FGalvagno/hsrl-control-pi/informe/portada.tex

% =============================================================
% Portada
% Regular espacios para que entre en una hoja, sin numerar (cuenta como i)
% =============================================================
\thispagestyle{empty}
\begin{center}
\begin{figure}[H]
    \centering
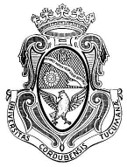
[picture p3: informe/figuras/0_unc.jpg]
    
\end{figure}

{\large UNIVERSIDAD NACIONAL DE C\'ORDOBA}\\[0.3cm]
{\large FACULTAD DE CIENCIAS EXACTAS, F\'ISICAS Y NATURALES}\\[0.3cm]
{\large CARRERA INGENIER\'IA ELECTR\'ONICA}

\vspace{1.5cm}

PROYECTO INTEGRADOR PARA LA OBTENCI\'ON DEL T\'ITULO DE GRADO\\
DE INGENIERO ELECTR\'ONICO

\vspace{2cm}

{\bfseries\Large ``SISTEMA AUTOMATIZADO DE CONTROL DE LONGITUD DE ONDA\\
PARA LIDAR DE ALTA RESOLUCI\'ON ESPECTRAL''}

\vspace{2cm}

\begin{tabular}{c}
Alumno \\[0.2cm]
Galvagno, Facundo Nahuel \\
\end{tabular}

\vspace{0.2cm}

\begin{tabular}{c}
Director \\[0.2cm]
Ing. Puig, Lucas M. D. \\
\end{tabular}

\vspace{0.2cm}

\begin{tabular}{c}
Co-Director \\[0.2cm]
Ing. Papandrea, Sebasti\'an Daniel \\
\end{tabular}

\vspace{0.2cm}

\begin{tabular}{c}
Co-Director \\[0.2cm]
Dr. Jin, Yoshitaka \\
\end{tabular}

\vspace{1.5cm}

C\'ordoba, Rep\'ublica Argentina\\
Agosto / 2026

\end{center}

\cleardoublepage
% Contratapa / reverso de tapa (version impresa tipo libro): pagina en blanco
\thispagestyle{empty}
\mbox{}
