FGalvagno/hsrl-control-pi/informe/preliminares/aprobacion_tribunal.tex

% =============================================================
% Hoja de Aprobacion del Tribunal Evaluador
% =============================================================
\thispagestyle{plain}

\begin{figure}[H]
    \centering
    
\end{figure}

\begin{center}
UNIVERSIDAD NACIONAL DE C\'ORDOBA\\
Facultad de Ciencias Exactas, F\'isicas y Naturales\\
Escuela de Ingenier\'ia Electr\'onica
\end{center}

\vspace{1.5cm}

El Tribunal Evaluador reunido en este acto y luego de haber aprobado la
Solicitud de Aprobaci\'on de Tema y efectuado las distintas instancias de
correcciones del Informe del Proyecto Integrador para la obtenci\'on del
T\'itulo de Grado ``Ingeniero Electr\'onico'' y cumpliendo con el Reglamento
correspondiente, declaran el Informe Final del estudiante Galvagno,
Facundo Nahuel como ``aceptado sin correcciones'' y la defensa oral Aprobada. Por lo tanto,
luego de haber tenido en cuenta los aspectos de evaluaci\'on que indica el
Reglamento, el Proyecto Integrador se considera Aprobado.

\vspace{1cm}

Se firma el Acta de Examen correspondiente y se distribuyen los ejemplares
impresos.

\vspace{2.5cm}

\noindent NOTA:

\vspace{2.5cm}

\noindent\hrulefill\\
Firma y aclaraci\'on del Tribunal Evaluador

\vspace{0.5cm}

\noindent Fecha:

\cleardoublepage
