FGalvagno/hsrl-control-pi/informe/preliminares/aval_director.tex

% =============================================================
% Aval del Director
% =============================================================
\thispagestyle{plain}

\begin{figure}[H]
    \centering
    
\end{figure}

\begin{center}
UNIVERSIDAD NACIONAL DE C\'ORDOBA\\
Facultad de Ciencias Exactas, F\'isicas y Naturales\\
Escuela de Ingenier\'ia Electr\'onica
\end{center}

\vspace{1.5cm}

Quien suscribe el Profesor Ing. Puig, Lucas M. D. en su carácter de Director del Proyecto Integrador del Estudiante Galvagno, Facundo Nahuel, denominado: SISTEMA AUTOMATIZADO DE CONTROL DE LONGITUD DE ONDA PARA
LIDAR DE ALTA RESOLUCIÓN ESPECTRAL, considera que el desarrollo del trabajo se ha completado según lo especificado en la Solicitud de Aprobación de Tema y se encuentra en condiciones de tramitar su defensa.

\vspace{1cm}

\noindent A los efectos de quien corresponda, en fecha \ldots /\ldots /\ldots

\vspace{3cm}

\hfill\begin{tabular}{c}
\hrulefill\\
Firma y aclaración del Director
\end{tabular}

\cleardoublepage
