FGalvagno/hsrl-control-pi/informe/anexos/anexo6_ilrc32.tex

% =============================================================
% Anexo IV - Abstract presentado en el ILRC32
% Avances presentados en la 32.a International Laser Radar Conference
% (5-10 de julio de 2026) \cite{galvagno2026ilrc}.
% =============================================================
\chapter{Abstract presentado en el ILRC32}
\label{anexo:ilrc32}

En el presente anexo se incluye el abstract/p\'oster ``Advances on
Automation of Wavelength Tuning for High Spectral Resolution Lidar''
\cite{galvagno2026ilrc}, presentado por el autor junto a los directores
y colaboradores del proyecto en la 32.\textsuperscript{a} International
Laser Radar Conference (ILRC32), donde se resumieron los avances
alcanzados hasta ese momento en el circuito de detecci\'on de picos y en
el modelo del fotodiodo (ver Cap\'itulos~\ref{cap:fotodeteccion} y
\ref{cap:diseno_deteccion_picos}).

\includepdf[pages=1,scale=0.85,offset=0 -28pt,pagecommand={\pagestyle{fancy}}]{anexos/pdf/ILRC32_abstract.pdf}
\includepdf[pages=2-,scale=0.85,offset=0 10pt,pagecommand={\pagestyle{fancy}}]{anexos/pdf/ILRC32_abstract.pdf}
\includepdf[pages=-,scale=0.85,offset=0 10pt,pagecommand={\pagestyle{fancy}}]{anexos/pdf/ILRC32Poster.pdf}
