FGalvagno/hsrl-control-pi/informe/anexos/anexo2_esquematico.tex

\chapter{Esquemático de la placa de control}
\label{anexo:esquematico}

Se reproducen a continuación las láminas del esquemático de la placa de
control descripta en el Capítulo \ref{cap:placacontrol}, exportadas desde
el proyecto de KiCad. La primera corresponde a la hoja raíz y las
restantes a las hojas jerárquicas del circuito de detección y del
circuito digital. Las láminas se imprimen en orientación apaisada para
conservar la legibilidad de las referencias y de los valores de los
componentes.

\begin{hojaapaisada}
\includepdf[pages=-,scale=0.92,pagecommand={\pagestyle{fancy}}]%
  {anexos/pdf/esquematico.pdf}
\end{hojaapaisada}
