FGalvagno/hsrl-control-pi/informe/anexos/anexo3_pcb.tex

\chapter{Circuito impreso (PCB) de la placa de control}
\label{anexo:pcb}

Se reproducen a continuación las láminas del circuito impreso descripto
en el Capítulo~\ref{cap:placacontrol}, exportadas desde el proyecto de
KiCad. Las primeras muestran por separado las capas de cobre y la
serigrafía; la última superpone todas las capas junto con el contorno de
placa y los componentes, tal como se envió a fabricación. Las láminas se
imprimen en orientación apaisada para conservar la escala del dibujo.

\begin{hojaapaisada}
\includepdf[pages=-,scale=0.92,pagecommand={\pagestyle{fancy}}]%
  {anexos/pdf/placa.pdf}
\includepdf[pages=-,scale=0.92,pagecommand={\pagestyle{fancy}}]%
  {anexos/pdf/placacompleta.pdf}
\end{hojaapaisada}
