FGalvagno/hsrl-control-pi/informe/main.tex

% !TEX root = main.tex
% =============================================================
% Informe Final - Proyecto Integrador
% Sistema Automatizado de Control de Longitud de Onda
% para LiDAR de Alta Resolucion Espectral (HSRL)
%
% Universidad Nacional de Cordoba
% Facultad de Ciencias Exactas, Fisicas y Naturales
% Carrera Ingenieria Electronica
%
% =============================================================

\documentclass[a4paper,11pt,twoside]{book}

% ---------- Idioma y codificacion ----------
\usepackage[utf8]{inputenc}
\usepackage[T1]{fontenc}
\usepackage[spanish,es-tabla]{babel}
\usepackage{textcomp} % simbolos como \textcelsius

% Nombres de secciones segun el manual de estilo (difieren de los
% predeterminados por babel-spanish: "Indice general", "Indice de
% tablas/figuras").
\addto\captionsspanish{%
  \renewcommand{\contentsname}{\'Indice}
  \renewcommand{\listtablename}{Lista de Tablas}
  \renewcommand{\listfigurename}{Lista de Figuras}
}
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
  \setlength{\paperwidth}{210mm}\setlength{\paperheight}{297mm}%
  \setlength{\pdfpagewidth}{210mm}\setlength{\pdfpageheight}{297mm}%
  \setlength{\headwidth}{\textwidth}%
}

%----------- Estilo de Tikz -----------
\input{diagramas/estilos-diagramas}

% ---------- Interlineado ----------
\usepackage{setspace}
\onehalfspacing % 1,5 espacios en el cuerpo del texto

% ---------- Figuras, tablas, graficos ----------
\usepackage{graphicx}
\usepackage{caption}
\usepackage{subcaption}
\usepackage{float}
\usepackage{booktabs}
\usepackage{longtable}
\usepackage{rotating} % hojas apaisadas para diagramas grandes
\usepackage{tabularx}
\usepackage{array}
% Figuras y tablas se separan del texto con 3 espacios (manual de
% estilo); formato de leyenda "Figura N: Descripcion (Fuente: ...)".
% Figuras y tablas: leyenda "Figura N: Descripcion (Fuente: ...)" sin negrita,
% centrada y algo mas angosta que el texto, pegada a la imagen. La separacion
% de 3 espacios del manual va entre el flotante y el cuerpo del texto.
\captionsetup{
  labelsep=colon,
  font=singlespacing,
  justification=centering,
  width=0.9\textwidth,
  skip=6pt
}
\setlength{\intextsep}{1.5\baselineskip}
\setlength{\textfloatsep}{1.5\baselineskip}

% ---------- Matematica ----------
\usepackage{amsmath}
\usepackage{amssymb}

% ---------- Codigo fuente (firmware / software) ----------
\usepackage{listings}
\usepackage{xcolor}

% ---------- Titulos de capitulo, seccion y subseccion ----------
% Capitulo: negrita 14 - Seccion: negrita 12 (numero seguido de punto,
% ej. "1.1.") - Subseccion: normal 12 (ej. "1.1.1"). Despues del titulo
% de Capitulo o Seccion: 3 espacios (aprox. 3 interlineados).
\usepackage{titlesec}
\titleformat{\chapter}[block]
  {\normalfont\bfseries\fontsize{14}{17}\selectfont}
  {Cap\'itulo \thechapter}{1em}{}
\titlespacing*{\chapter}{0pt}{0pt}{1.5\baselineskip}

\titleformat{\section}
  {\normalfont\bfseries\fontsize{12}{14}\selectfont}{\thesection.}{1em}{}
\titlespacing*{\section}{0pt}{1.3\baselineskip}{0.7\baselineskip}

\titleformat{\subsection}
  {\normalfont\fontsize{12}{14}\selectfont}{\thesubsection}{1em}{}
\titlespacing*{\subsection}{0pt}{1\baselineskip}{0.5\baselineskip}

% Rotulo de las entradas de anexo en el indice: en lugar del numero solo
% ("I", "II", ...) se compone "Anexo I: Titulo". Se activa mas abajo, al
% entrar en \appendix, sustituyendo \numberline dentro del propio .toc.
\newcommand{\anexonumberline}[1]{Anexo~#1:\hspace{0.5em}}

% ---------- Bibliografia y referencias ----------
% Numeracion continua entre Bibliografia (solo libros con ISBN) y Referencias
% (todo lo demas: links, hojas de datos, apuntes, IA, etc.)
\usepackage[
  backend=biber,
  style=numeric,
  sorting=none,
  defernumbers=true
]{biblatex}
\addbibresource{bibliografia.bib}
% Bibliografia/Referencias: espacio simple dentro de cada entrada y
% separacion de 1,5 interlineados entre entradas (manual de estilo).
\AtBeginBibliography{\singlespacing}
\setlength{\bibitemsep}{1.5\baselineskip}
\setlength{\bibhang}{0pt}

% Notas al pie y citas textuales en espacio simple (manual de estilo),
% independientemente del interlineado 1,5 del cuerpo del texto. El
% paquete setspace tipografia las notas al pie a espacio simple en
% forma automatica; solo se fuerza el espaciado en citas textuales.
\usepackage{etoolbox}
\AtBeginEnvironment{quote}{\singlespacing}
\AtBeginEnvironment{quotation}{\singlespacing}

% ---------- Encabezados y pies de pagina ----------
\usepackage{fancyhdr}
\setlength{\headheight}{14pt}
\pagestyle{fancy}
\fancyhf{}
\fancyhead[LE,RO]{\thepage}
\fancyhead[RE]{\nouppercase{\leftmark}}
\fancyhead[LO]{\nouppercase{\rightmark}}
\renewcommand{\headrulewidth}{1pt}
\fancypagestyle{plain}{
  \fancyhf{} % Limpia el pie de página
  \renewcommand{\headrulewidth}{0pt} % Quita la regla superior en estas páginas
}
% ---------- Hipervinculos ----------
\usepackage[hidelinks]{hyperref}
\usepackage{cleveref}

% =============================================================
\begin{document}

% -------------------------------------------------------------
% PORTADA (no se numera; la numeracion romana visible comienza
% en la pagina siguiente, con la Hoja de Aprobacion del Tribunal)
% -------------------------------------------------------------
\input{portada}

% -------------------------------------------------------------
% PRELIMINARES (numeracion romana)
% -------------------------------------------------------------
\pagenumbering{roman}
% El manual de estilo pide numeros romanos en minuscula lisa (i, ii,
% iii...)
\makeatletter
\renewcommand{\es@scroman}[1]{#1}
\makeatother
\renewcommand{\thepage}{\roman{page}}
\input{preliminares/aprobacion_tribunal}
\input{preliminares/aval_director}
\input{preliminares/dedicatoria}
\input{preliminares/agradecimientos}
\input{preliminares/resumen}
\input{preliminares/abstract}
\input{preliminares/resumo}

\cleardoublepage
\tableofcontents

\listoftables
\addcontentsline{toc}{chapter}{\listtablename}

\listoffigures
\addcontentsline{toc}{chapter}{\listfigurename}

\input{preliminares/lista_simbolos_v2}

% -------------------------------------------------------------
% CUERPO DEL INFORME (numeracion arabiga desde Capitulo 1)
% -------------------------------------------------------------
\mainmatter

\input{capitulos/cap01_introduccion}

\part{Marco Teórico}
\input{capitulos/cap02_lidar_hsrl}
\input{capitulos/cap03_fotodeteccion}

\part{Marco Metodológico}
\input{capitulos/cap04_deteccion_picos}
\input{capitulos/cap05_microcontrolador}
\input{capitulos/cap06_placa_control}
\input{capitulos/cap07_firmware}
\input{capitulos/cap08_software_hmi}
\input{capitulos/cap09_modeloexp}

\part{Resultados y Conclusiones}
\input{resultados}
\input{conclusiones}

% -------------------------------------------------------------
% BIBLIOGRAFIA Y REFERENCIAS (numeracion continua)
% -------------------------------------------------------------
% El titulo se compone con \chapter*, igual que Resultados y Conclusiones, para
% que herede el formato definido con titlesec. Por eso ambos \printbibliography
% van con heading=none: la opcion title no tiene efecto en ese caso.
\cleardoublepage
\chapter*{Bibliografía}
\phantomsection
\addcontentsline{toc}{chapter}{Bibliografía}
\printbibliography[type=book,heading=none]

\cleardoublepage
\chapter*{Referencias}
\phantomsection
\addcontentsline{toc}{chapter}{Referencias}
\printbibliography[nottype=book,heading=none]

% -------------------------------------------------------------
% ANEXOS
% -------------------------------------------------------------
\appendix

% Los anexos se numeran en romanos y se rotulan "Anexo" (no "Capitulo"),
% segun el manual de estilo. \appendix asigna letras por defecto.
\renewcommand{\thechapter}{\Roman{chapter}}
\titleformat{\chapter}[block]
  {\normalfont\bfseries\fontsize{14}{17}\selectfont}
  {Anexo \thechapter}{1em}{}

% En el indice, la entrada de capitulo se compone con \numberline{\thechapter},
% que para los anexos produce solo "I", "II", etc. Se redefine \numberline
% dentro del propio archivo .toc a partir de este punto, de modo que las
% entradas restantes queden rotuladas como "Anexo I: Titulo".
\renewcommand{\appendixname}{Anexo}
\addtocontents{toc}{\protect\let\protect\numberline\protect\anexonumberline}

% Orden segun aparicion en el cuerpo del informe.
\input{anexos/anexo1_codigo_nies}
\input{anexos/anexo2_esquematico}
\input{anexos/anexo3_pcb}
\input{anexos/anexo4_hojas_datos}
\input{anexos/anexo5_codigo}
\input{anexos/anexo6_ilrc32}

% -------------------------------------------------------------
% ANEXO DE LA CATEDRA PI 
% -------------------------------------------------------------
\backmatter
\cleardoublepage
\phantomsection
\addcontentsline{toc}{chapter}{Anexo del Proyecto Integrador}
\chapter*{Anexo del Proyecto Integrador}
  En el presente anexo se incluyen la Solicitud de Aprobación de Tema y los informes mensuales de avance del proyecto, presentados a la Cátedra de Proyecto Integrador durante el desarrollo del mismo.
\input{anexos/sat}
\input{anexos/informes_mensuales}

\end{document}
