FGalvagno/hsrl-control-pi/informe/capitulos/cap07_firmware.tex

% =====================================================================
%  Capítulo: Firmware de control embebido sobre Raspberry Pi Pico 2
%  Fragmento para insertar con \input{} en el documento principal.
%  Paquetes requeridos en el preambulo de la tesis: graphicx, booktabs,
%  listings, xcolor, amsmath, float, caption.
%  Ademas, en el preambulo:  \input{diagramas/estilos-diagramas}
%  (carga tikz y los estilos que usan las figuras de este capitulo).
%  Las figuras se incluyen con \input{diagramas/<nombre>}.
% =====================================================================

\chapter{Firmware de control embebido}
\label{cap:firmware}

Tal como se explicó en el Capítulo \ref{cap:introduccion}, el sistema de control de longitud de onda del \emph{seeder} del lidar HSRL fue originalmente implementado como un programa de PC, \texttt{wvcnt\_lec.cpp}, que adquiría las señales del detector a través de un osciloscopio Tektronix vinculado por USB-VISA y comandaba el \emph{seeder} por un puerto serie.

El \emph{firmware} documentado en este capítulo traslada la totalidad del lazo a un microcontrolador Raspberry Pi Pico 2 (RP2350). 

\section{Alcance de la funcionalidad del Firmware}
\label{sec:fw-alcance}

El microcontrolador digitaliza las señales $P_+$ y $P_-$ directamente con su conversor analógico-digital interno, sincronizado por hardware con la señal de sincronismo del láser \emph{host}, y escribe el \textit{setpoint} de temperatura del \emph{heater} del \emph{seeder} Continuum por una terminal serie asincrónica. La consola de operación se expone sobre USB en modo CDC, de forma que la interfaz gráfica descripta en el capítulo~\ref{cap:software_hmi} sea para monitoreo y cambio de modos, no así parte del lazo de control. Por lo tanto si la interfaz se cierra, el \emph{firmware} continúa controlando el proceso en el último estado en el que se encontraba.

\section{Principio de funcionamiento del control}
\label{sec:fw-principio}

El detector entrega dos señales, $P_+$ y $P_-$, tomadas a ambos lados de la línea de absorción. La variable controlada no es ninguna de ellas por separado sino su cociente

\begin{equation}
  \mathit{prt} \;=\; \frac{P_+}{P_-},
  \label{eq:prt}
\end{equation}

\noindent que resulta monótono creciente con la longitud de onda en el entorno del punto de trabajo. El uso del cociente en lugar de una amplitud absoluta cancela, en primer orden, las variaciones comunes a ambos canales: fluctuaciones de la energía por pulso del láser, deriva de ganancia del detector y cambios de transmisión del camino óptico. El lazo corrige entonces el \emph{setpoint} de temperatura para mantener este cociente dentro de una banda determinada, utilizando un control por histéresis con banda muerta.

El barrido inicial aprovecha que cada canal absorbe a una longitud de onda distinta: al barrer la temperatura, $P_+$ y $P_-$ atraviesan sus respectivos mínimos a temperaturas diferentes, y el punto de operación buscado es la temperatura media entre ambos. 

\section{Arquitectura del sistema}
\label{sec:fw-arquitectura}

La Figura~\ref{fig:fw-arquitectura} muestra la disposición del hardware y los enlaces de señal. El generador de ondas que dispara el láser entrega también el trigger que sincroniza la digitalización. Las salidas del detector se acondicionan al rango de entrada del conversor del RP2350 mediante un divisor resistivo y se conectan a dos canales analógicos. La comunicación con el \emph{seeder} es RS-232 y requiere un conversor de niveles respecto de la lógica TTL del microcontrolador. La terminal de operación y monitoreo funciona sobre USB en modo CDC.

\begin{figure}[htpb]
\centering
\resizebox{\textwidth}{!}{\input{diagramas/fw-arquitectura}}
\caption[Arquitectura de hardware del sistema de control]%
{Arquitectura de hardware (Fuente: elaboración propia).}
\label{fig:fw-arquitectura}
\end{figure}

El conexionado concreto se resume en la tabla~\ref{tab:fw-pines}. Todas las asignaciones de pines están centralizadas en \texttt{config.h}, de modo que una modificación del cableado no obliga a recorrer el resto del código.

\begin{table}[htbp]
\centering
  \begin{tabular}{@{}llp{0.20\textwidth}p{0.34\textwidth}@{}}
  \toprule
  \textbf{Señal} & \textbf{GPIO} & \textbf{Periférico} & \textbf{Observaciones} \\
  \midrule
  Trigger       & 13 & GPIO entrada & \textit{pull-down} interno habilitado \\
  $P_+$       & 26 & ADC canal 0  & rango $0$--$3{,}3$\,V \\
  $P_-$       & 27 & ADC canal 1  & rango $0$--$3{,}3$\,V \\
  Seeder TX     & 0  & UART0 TX     & $57\,600$ baud, 8N1 \\
  Seeder RX     & 1  & UART0 RX     & sin control de flujo \\
  LED de estado & --- & GPIO (\texttt{PICO\_DEFAULT\_} \texttt{LED\_PIN}) & señalización durante el arranque \\
  \bottomrule
  \end{tabular}
  \caption{Asignación de pines del RP2350 para la aplicación en HSRL (Fuente: elaboración propia).}
 \label{tab:fw-pines}
\end{table}

\subsection{Descomposición en módulos}

El \emph{firmware} se organiza en cuatro archivos más un encabezado de configuración, según se ilustra en la figura~\ref{fig:fw-modulos}. El criterio de partición es funcional puesto que cada módulo encapsula una función determinada. El módulo \texttt{control} en particular no conoce ni el conversor ni el puerto serie: recibe dos valores en punto flotante y devuelve incrementos, lo que lo hace verificable de forma aislada.

\begin{figure}[htbp]
\centering
\resizebox{0.92\textwidth}{!}{\input{diagramas/fw-modulos}}
\caption{Descomposición en módulos del firmware y sus dependencias (Fuente: elaboración propia).}
\label{fig:fw-modulos}
\end{figure}

\begin{table}[h]
\centering
  \begin{tabular}{@{}p{0.28\textwidth}p{0.64\textwidth}@{}}
  \toprule
  \textbf{Archivo} & \textbf{Responsabilidad} \\
  \midrule
  \texttt{hsrl-control.c} & \texttt{main()}, lazo de medición sobre \texttt{core0}, intérprete de comandos sobre \texttt{core1} y emisión de la línea \texttt{[log]} de guardado de datos. \\
  \texttt{adc\_capture.c/.h} & Captura del valor de pico de cada canal, sincronizada al trigger, y promediado de $n$ cantidad de capturas. \\
  \texttt{control.c/.h} & Máquina de estados de los modos de operación y cálculo de los incrementos del punto de consigna o set point. \\
  \texttt{seeder\_comm.c/.h} & Protocolo de comandos de texto tipo SCPI sobre UART. \\
  \texttt{config.h} & Pines, parámetros por defecto y límites de seguridad. Único punto de configuración operativa del sistema. \\
  \bottomrule
  \end{tabular}
  \caption{Responsabilidad de cada módulo (Fuente: elaboración propia).}
\label{tab:fw-modulos}
\end{table}

\section{Conversión de las señales del detector}
\label{sec:fw-adquisicion}

\subsection{Sincronismo y detección de pico}

La señal que entrega el detector es un pulso cuya amplitud de pico es la magnitud de interés. Como se describió anteriormente en el Capítulo \ref{cap:micro}, la estrategia de captura consiste en muestrear a la máxima velocidad posible durante la ventana en que el trigger permanece en nivel alto y conservar el máximo de las muestras obtenidas. El código~\ref{lst:fw-adc} reproduce el núcleo de la rutina.

\begin{lstlisting}[language=C,caption={Captura de pico sincronizada al trigger
  (\texttt{adc\_capture.c}).},label={lst:fw-adc},basicstyle=\ttfamily\footnotesize,
  columns=fullflexible,breaklines=true,frame=single,rulecolor=\color{black!30}]
uint16_t adc_capturar_pico(uint canal) {
    uint16_t maximo = 0;
    adc_select_input(canal);

    while (!gpio_get(PIN_TRIGGER)) {   // esperar el flanco de subida
        tight_loop_contents();
    }
    sleep_us(2);                       // retardo de establecimiento

    adc_fifo_setup(true, false, 1, false, false);
    adc_run(true);                     // free-running con FIFO

    while (gpio_get(PIN_TRIGGER)) {    // mientras dure el pulso
        if (!adc_fifo_is_empty()) {
            uint16_t val = adc_fifo_get();
            if (val > maximo) maximo = val;
        }
    }
    adc_run(false);

    while (!adc_fifo_is_empty()) {     // vaciar lo que quedo en el FIFO
        uint16_t val = adc_fifo_get();
        if (val > maximo) maximo = val;
    }
    adc_fifo_drain();
    return maximo;
}
\end{lstlisting}

En primer lugar, el conversor se configura sin divisor de reloj (\texttt{adc\_set\_clkdiv(0)}), lo que produce una tasa de conversión cercana a $500$\,kmuestras/s; con anchos de pulso del orden de la decena de microsegundos esto asegura varias muestras dentro de la ventana. En segundo lugar, la habilitación del FIFO desacopla la conversión de la lectura, de modo que una demora del lazo de software no pierde la muestra en curso. En tercer lugar, el retardo de $2$\,\textmu s posterior al flanco descarta el transitorio de establecimiento del multiplexor de entrada y el tiempo de encendido de láser, que de otro modo se computaría como una muestra incorrecta.

La resolución del conversor es de 12 bits sobre una referencia de $3{,}3$\,V, lo que da un escalón de cuantificación de $3{,}3/4095 \approx 0{,}806$\,mV.

\subsection{Muestreo intercalado y promediado}

Los dos canales se muestrean de forma intercalada: un pulso de trigger para $P_+$ y el siguiente para $P_-$. Como el cociente de la ecuación~\ref{eq:prt} se construye con mediciones tomadas en disparos consecutivos, el intercalado minimiza el intervalo entre ambas y, con él, la contribución de la deriva de temperatura al error. 

El sistema permite fijar en caliente el número $n$ de picos a promediar por canal, entre 1 y \texttt{N\_PROM\_MAX} $=100$. Los acumuladores son de 32 bits, holgadamente suficientes para $100$ muestras de 12 bits.

\subsection{Espera de estabilización}

El calentador de cavidad del láser \emph{seeder} presenta una constante de tiempo térmica no despreciable frente al período del ciclo. El \emph{setpoint} se escribe al final de un ciclo, pero la temperatura efectiva de la cavidad tarda en alcanzarlo. Medir inmediatamente después de la escritura equivaldría a muestrear sobre un transitorio, con el resultado de que el lazo reaccionaría a su propia dinámica de actuación en lugar de a la del proceso.

Por ese motivo el ciclo comienza con una pausa configurable, \texttt{espera\_ms} (comando \texttt{E}), de valor por defecto $10$\,s y tope $600$\,s. Durante la pausa el segundo núcleo continúa atendiendo comandos, de modo que el propio parámetro puede modificarse sin esperar a que el ciclo concluya.

\section{Lazo de control}
\label{sec:fw-control}

\subsection{Modos de operación}

El controlador implementa cinco modos, que la figura~\ref{fig:fw-estados} presenta como una máquina de estados. Los modos \textsc{forward} y \textsc{backward} realizan un barrido en lazo abierto aplicando un incremento de paso grueso en cada ciclo, y son los que se utilizan durante la búsqueda de los mínimos. El modo \textsc{lock} es el único que cierra el lazo de control.

\begin{figure}[h]
\centering
\resizebox{\textwidth}{!}{\input{diagramas/fw-estados}}
\caption[Máquina de estados de los modos de operación]%
{Máquina de estados de los modos de operación. Las transiciones punteadas no provienen de un comando sino de la protección de rango de temperatura máxima (Fuente: elaboración propia).}
\label{fig:fw-estados}
\end{figure}

\subsection{Ley de control del sistema}

Al ingresar en el modo \textsc{lock} el controlador captura como referencia $\mathit{prt}_{\mathrm{ref}}$ el valor del cociente correspondiente a \textbf{dos ciclos atrás}. El criterio tiene una justificación, ya que el ciclo inmediatamente anterior pudo haberse medido mientras la temperatura todavía convergía hacia el último punto de consigna del barrido, mientras que el ciclo previo a ése corresponde a una condición ya estabilizada. Tomar la referencia del historial evita, además, introducir un ciclo adicional de espera al momento de la sintonización.

La ley de control es de tipo histéresis \emph{bang-bang} con banda muerta multiplicativa:

\begin{equation}
  \Delta_{\text{heater}} =
  \begin{cases}
    -\,\delta_{f} & \text{si } \mathit{prt} > \mathit{prt}_{\mathrm{ref}}\cdot\mathrm{coe},\\[4pt]
    +\,\delta_{f} & \text{si } \mathit{prt} < \mathit{prt}_{\mathrm{ref}}/\mathrm{coe},\\[4pt]
    0             & \text{en otro caso},
  \end{cases}
  \label{eq:lock}
\end{equation}

donde $\delta_{f}$ es el paso fino de temperatura y $\mathrm{coe}=1{,}23$ el coeficiente de banda muerta. La figura~\ref{fig:fw-banda} representa gráficamente la ecuación~\ref{eq:lock}.

\begin{figure}[htbp]
\centering
\resizebox{0.95\textwidth}{!}{\input{diagramas/fw-banda}}
\caption[Banda muerta multiplicativa del modo de sintonía]%
{Banda muerta multiplicativa del modo de sintonía. El ancho relativo de la banda es constante y no depende del valor absoluto de la referencia (Fuente: elaboración propia).}
\label{fig:fw-banda}
\end{figure}

La elección de una banda \emph{multiplicativa} es debido a que el cociente $\mathit{prt}$ carece de unidades y su valor absoluto puede variar entre sesiones según el punto de trabajo. La banda cumple la función habitual de la zona muerta en un control \textit{bang-bang}: impedir que el actuador corrija permanentemente sobre el ruido de medición, a costa de un error de régimen acotado y de un ciclo límite de amplitud igual, a lo sumo, a un paso fino.

\subsection{Protección de rango}

Antes de calcular el incremento o decremento de temperatura de cavidad, cada ciclo verifica que el \emph{setpoint} permanezca dentro del intervalo $[h_{\min}, h_{\max}]$ declarado en \texttt{config.h} (por defecto $62{,}5$--$63{,}1$\,\textdegree C). Si lo excede, el controlador fuerza el modo de barrido en dirección opuesta al actual. Si el sistema está sintonizado, anula la bandera \texttt{lock\_activo}, volviendo al modo de barrido.

\subsection{Estructura del ciclo}

La Figura \ref{fig:fw-ciclo} sintetiza el ciclo completo que ejecuta \texttt{core0}. Primero el sistema copia \texttt{n\_prom} y \texttt{espera\_ms} en sección crítica, debido a que estas variables son escritas por el \texttt{core1} pero accedidas por el \texttt{core0}. El uso de una sección crítica \cite{rpisdk} permite evitar los problemas típicos de concurrencia al acceder simultáneamente a una variable, como condición de carrera o \textit{race\ condition}. Luego el ciclo espera el tiempo de estabilización (de ser necesario), captura los pulsos del ADC ante una entrada de SYNC (señal de sincronismo del láser \emph{host}), los normaliza y escala para posteriormente aplicar la ley de control y enviar los \emph{setpoints} al \emph{seeder}.

Finalmente, el microcontrolador confirma los valores escritos en el \emph{seeder} y al terminar el ciclo envía todas las variables consultadas anteriormente en la terminal, con la etiqueta \texttt{log}.

\begin{figure}[htpb]
\centering
\resizebox{!}{0.85\textheight}{\input{diagramas/fw-ciclo}}
\caption{Ciclo de medición y control ejecutado por \texttt{core0} (Fuente: elaboración propia).}
\label{fig:fw-ciclo}
\end{figure}

\section{Comunicación con el seeder}
\label{sec:fw-seeder}

\subsection{Protocolo}

El \emph{seeder} Continuum expone un conjunto de comandos de texto de sintaxis similar a SCPI, terminados en \texttt{\textbackslash r\textbackslash n}, sobre una línea RS-232 configurada a $57\,600$ baudios, 8N1, sin control de flujo. La Tabla~\ref{tab:fw-scpi} enumera los comandos utilizados por el \emph{firmware}.

\begin{table}[htbp]
\centering
  \begin{tabular}{@{}p{0.34\textwidth}p{0.58\textwidth}@{}}
  \toprule
  \textbf{Comando} & \textbf{Función} \\
  \midrule
  \texttt{:syst:pass:cen "NP"}    & Habilitar los comandos protegidos. \\
  \texttt{:syst:pass:cdis "NP"}   & Volver a protegerlos. \\
  \texttt{:syst:pass:cen:stat?}   & Estado de la protección. \\
  \texttt{:syst:tcon2:spo} \textbar\ \texttt{?} & Escribir o leer el punto de consigna del calefactor. \\
  \texttt{:syst:tmon2:temp?}      & Leer la temperatura medida. \\
  \texttt{:syst:pdr:volt} \textbar\ \texttt{?}  & Escribir o leer la tensión del piezoeléctrico. \\
  \texttt{:syst:smod:flag?}       & Banderas de \emph{second mode}. \\
  \texttt{:syst:err?}             & Cola de errores (FIFO, hasta 10 entradas). \\
  \texttt{*CLS}                   & Limpiar la cola de errores. \\
  \bottomrule
  \end{tabular}
  \caption{Comandos del seeder empleados por el firmware (Fuente: adaptado de \cite{npphotonics_flm005}).}
\label{tab:fw-scpi}
\end{table}

\subsection{Habilitación de los comandos protegidos}

El \emph{seeder} inicia siempre con los comandos de configuración protegidos. Esto quiere decir que sin habilitación previa, las escrituras de temperatura y de tensión del piezoeléctrico se descartan. El \emph{firmware} envía la contraseña durante la inicialización del mismo, incluso antes de esperar a que se establezca la consola USB, y reintenta hasta \texttt{UNLOCK\_MAX\_INTENTOS} $=5$ veces con \texttt{UNLOCK\_REINTENTO\_MS} $=2000$\,ms de separación, porque el \emph{seeder} puede encontrarse todavía en su propia secuencia de arranque cuando el microcontrolador ya está operativo.

Durante esta etapa no hay consola disponible, de modo que los mensajes de diagnóstico se perderían. Como única señal de vida se utiliza el LED de la placa, encendido de forma continua mientras se cursa un intento y parpadeando durante la espera entre intentos, lo que permite distinguir a simple vista el estado actual de la placa. El resultado se almacena y se informa por consola una vez que se establece conexión con la interfaz serie del \emph{seeder}.

Un detalle de implementación merece mención por lo difícil que resultó de diagnosticar. La secuencia de habilitación del \emph{seeder} debe comenzar enviando \texttt{*CLS}, comando cuyo efecto útil es evitar que el \emph{seeder} detecte como byte de datos algún flanco ocurrido al configurar el UART. Sin este comando, la habilitación de los comandos protegidos no era posible.

\subsection{Verificación de escrituras y diagnóstico}

Dado que el protocolo no acusa recibo de las escrituras, el \emph{firmware} implementa una verificación explícita mediante el comando \texttt{w}: lee el \emph{setpoint} antes de escribirlo por terminal, lo escribe, y lo vuelve a leer. La comparación permite distinguir tres situaciones: aceptación, rechazo (el valor no se movió) y una condición anómala en la que el \emph{seeder} adoptó un valor distinto del solicitado. El comando \texttt{d} complementa lo anterior consultando el estado de la protección y vaciando la cola de errores del \emph{seeder}. Los códigos posibles son $-203$ (comando protegido), $-102$ (error de sintaxis), $-121$ (carácter inválido en un número) y $-222$ (dato fuera de rango). Su implementación se realizó con ayuda del manual de referencia \cite{npphotonics_flm005}, utilizando código de ejemplo del mismo.

\subsection{Detección de segundo modo}

Al cierre de cada ciclo el \emph{firmware} consulta \texttt{:syst:smod:flag?}. El bit 0 en 1 indica que el \emph{seeder} abandonó la operación en monomodo o \textit{single mode} hacia \emph{second mode}, condición bajo la cual la medición de ese ciclo no es representativa.

El \emph{firmware} informa la condición pero no actúa sobre ella: no descarta la medición ni suspende el lazo. Esta decisión es deliberada puesto que podría enmascarar un problema con el lidar. Por este motivo es posible cambiar la tensión del piezoeléctrico del \emph{seeder}. Al cambiar la tensión del piezoeléctrico podemos quitar al \emph{seeder} de la condición de \emph{second mode}.

\section{Concurrencia y aprovechamiento de los dos núcleos}
\label{sec:fw-concurrencia}

El ciclo de medición es intrínsecamente bloqueante: la espera del trigger, la pausa de estabilización y las transacciones con el \emph{seeder} inmovilizan el hilo de ejecución por intervalos que pueden alcanzar varios segundos. Atender la consola desde ese mismo hilo obligaría a realizar un \textit{polling} del puerto entre operaciones o utilizar interrupciones.

Puesto que el RP2350 dispone de dos núcleos, se dispone de una solución directa: \texttt{core0} ejecuta el lazo de medición y control, y \texttt{core1} atiende la consola en modo bloqueante. El diagrama de secuencias de la Figura \ref{fig:fw-secuencia} ilustra la interacción entre los dos núcleos y los recursos compartidos.

\begin{figure}[htbp]
\centering
\resizebox{\textwidth}{!}{\input{diagramas/fw-secuencia}}
\caption[Concurrencia entre núcleos y arbitraje de recursos compartidos]%
{Concurrencia entre núcleos y arbitraje de los dos recursos compartidos (Fuente: elaboración propia).}
\label{fig:fw-secuencia}
\end{figure}

Existen dos recursos compartidos, y cada uno recibe el mecanismo de exclusión que le corresponde:

\begin{itemize}
\item \textbf{Las estructuras de parámetros y estado} (\texttt{g\_params}, \texttt{g\_estado}) se protegen con una sección crítica (\texttt{critical\_section\_t}), que inhibe las interrupciones. Las regiones protegidas son deliberadamente breves (una asignación y una copia de la estructura) de modo que \texttt{core0} nunca queda esperando por una operación de salida.

\item \textbf{El puerto UART hacia el seeder} se protege con un \emph{mutex} (\texttt{mutex\_t}). Aquí la elección es distinta porque una transacción completa (envío del comando y lectura de la respuesta) puede demorar cientos de milisegundos, y mantener las interrupciones inhibidas durante ese intervalo degradaría el resto del sistema. El envío y la lectura deben ejecutarse bajo el mismo bloqueo puesto que si se separaran, el otro núcleo podría enviar un comando diferente y los núcleos leerían respuestas cruzadas en el puerto UART.
\end{itemize}

Adicionalmente, el valor de $n$ y el tiempo de espera se copian a variables locales al comienzo de cada ciclo, bajo la sección crítica. La copia rige para todo el ciclo, de modo que un cambio ordenado por el operador a mitad del promediado no altera el número de muestras que se están acumulando. Esto implica que el nuevo valor entra en vigor a partir del ciclo siguiente.

\section{Interfaz de operación}
\label{sec:fw-consola}

\subsection{Consola de comandos}

La consola distingue dos familias de comandos. Los de modo y consulta constan de un único carácter y se ejecutan de inmediato. Los comandos de parámetro constan de una letra seguida de un valor y se acumulan en un buffer hasta recibir el fin de línea. Los comandos posibles se encuentran detallados en la Tabla \ref{tab:fw-params}.

\begin{table}[htbp]
\centering
  \begin{tabular}{@{}cllr@{}}
  \toprule
  \textbf{Cmd} & \textbf{Parámetro} & \textbf{Ejemplo} & \textbf{Defecto} \\
  \midrule
  \texttt{P} & Tensión del piezoeléctrico        & \texttt{P2.500}    & $2{,}0$ \\
  \texttt{V} & Paso del piezoeléctrico           & \texttt{V0.010}    & $0{,}0$ \\
  \texttt{T} & Punto de consigna del calefactor  & \texttt{T62.140}   & $62{,}14$ \\
  \texttt{N} & Límite inferior del calefactor    & \texttt{N62.500}   & $62{,}5$ \\
  \texttt{X} & Límite superior del calefactor    & \texttt{X63.100}   & $63{,}1$ \\
  \texttt{R} & Paso grueso                       & \texttt{R0.069923} & $0{,}069923$ \\
  \texttt{M} & Paso medio                        & \texttt{M0.017750} & $0{,}01775$ \\
  \texttt{I} & Paso fino                         & \texttt{I0.004438} & $0{,}0044375$ \\
  \texttt{A} & Picos a promediar por canal       & \texttt{A5}        & $1$ (máx. $100$) \\
  \texttt{E} & Espera de estabilización, s       & \texttt{E10}       & $10$ (máx. $600$) \\
  \bottomrule
  \end{tabular}
  \caption{Comandos de parámetro y sus valores por defecto (Fuente: elaboración propia).}
\label{tab:fw-params}
\end{table}

Los comandos \texttt{A} y \texttt{E} son los únicos que aplican saturación sobre el valor recibido para limitar rangos; el resto se acepta tal cual, delegando la validación de rango en el \emph{seeder}, que responde con el código $-222$ ante un dato fuera de rango. Nótese que la tensión del piezoeléctrico se escribe pero su paso permanece en cero porque para esta versión del software la totalidad de la sintonización se realiza por temperatura.

\subsection{Registro de variables del sistema}
\label{sec:fw-log}

La salida por consola cumple dos propósitos difícilmente compatibles entre sí. Durante la puesta a punto a un operador o al mismo desarrollador le interesa una traza legible, con una línea por operación y suficiente contexto para entender qué está haciendo el sistema. Para una HMI, en cambio, esa misma traza obliga al programa corriendo en la PC a reconstruir el estado del equipo juntando fragmentos dispersos en varias líneas de la terminal con diversos contextos.

La solución adoptada consiste en mantener la traza legible y agregar, al cierre de cada ciclo de medición, una única línea autocontenida en formato CSV:

\begin{lstlisting}[basicstyle=\ttfamily\scriptsize,columns=fullflexible,
  breaklines=true,frame=single,rulecolor=\color{black!30}]
[log] 27,f,62.8500,62.8471,2.0000,2.0013,0.312345,0.253012,1.234567,
      +0.069923,0,,,,1,10,0,0
\end{lstlisting}

Los nombres de las columnas no se codifican dentro de la línea de datos sino que se transmiten por separado, al arrancar y como respuesta al comando \texttt{?}:

\begin{lstlisting}[basicstyle=\ttfamily\scriptsize,columns=fullflexible,
  breaklines=true,frame=single,rulecolor=\color{black!30}]
[logcols] ciclo,modo,heater_sp,heater_real,piezo_sp,piezo_real,pp,pm,prt,
          d_heater,lock_activo,lock_ref,lock_lo,lock_hi,n_prom,espera_s,
          smod,segundo_modo
\end{lstlisting}

Esto permite que el software que recibe la información por puerto serie pueda construir el encabezado de su archivo de salida a partir de lo que el \emph{firmware} declara, en lugar de mantener una copia de la lista. Si en el futuro se agregan columnas, el mismo software de PC las incorpora sin modificaciones. 

El csv generado además posee dos reglas de interpretación:

\begin{enumerate}
\item El separador es la coma y el separador decimal es el punto según formato de archivos \texttt{csv} tradicional.
\item Un campo vacío significa que el dato no existe en ese ciclo, y no que valga cero.
\end{enumerate}

Esta última distinción permite diferenciar una situación de no respuesta del \emph{seeder} (que sería causal de alarma para la interfaz), de un cero verdadero.

\section{Configuración y compilación}
\label{sec:fw-build}

Toda la parametrización del sistema reside en \texttt{config.h}: pines, velocidades de comunicación, parámetros de reintento, valores por defecto del control y límites de seguridad. La regla de diseño es que ninguna constante significativa aparezca dispersa en el código.

La compilación se realiza con CMake y Ninja sobre el SDK oficial de Raspberry Pi Pico en su versión 2.3.0, con la cadena de herramientas ARM 15\_2\_Rel1. La placa objetivo se declara como \texttt{PICO\_BOARD=pico2}. La salida estándar se dirige a USB y no a UART, ya que este último está dedicado por completo a la comunicación con el \emph{seeder}:

\begin{lstlisting}[basicstyle=\ttfamily\footnotesize,columns=fullflexible,
  frame=single,rulecolor=\color{black!30}]
pico_enable_stdio_uart(hsrl-control 0)
pico_enable_stdio_usb(hsrl-control 1)

target_link_libraries(hsrl-control
        pico_stdlib
        hardware_adc  hardware_gpio  hardware_uart
        hardware_sync pico_multicore)
\end{lstlisting}
