FGalvagno/hsrl-control-pi/informe/capitulos/cap08_software_hmi.tex

% =============================================================
% Capítulo 9 - Desarrollo del software de interfaz (HMI)
% =============================================================
\chapter{Desarrollo del software de interfaz (HMI)}
\label{cap:software_hmi}

El software de interfaz hombre-máquina (HMI, por sus siglas en inglés \emph{Human-Machine Interface}) constituye la capa de supervisión y control del sistema automatizado de sintonización en longitud de onda para el HSRL. Este desarrollo reemplaza el esquema previo basado en scripts en Visual C++ por una solución integrada, robusta y amigable para el operador.

El software HMI debe permitir la interacción entre el usuario y el microcontrolador de la placa de control, incluyendo la visualización del estado de sintonización del sistema, la lectura de parámetros del lazo de control y la modificación de funciones y \emph{setpoints} de operación.

\section{Requisitos funcionales y de diseño}
\label{sec:reqhmi}

Para garantizar la operabilidad, confiabilidad y seguridad del sistema, se establecieron los siguientes requisitos funcionales y de diseño específicos:

\begin{itemize}
    \item Visualización continua del estado operativo de sintonización (sintonizando, bloqueado en longitud de onda, fuera de rango o error), así como el despliegue gráfico de las señales adquiridas por los detectores de pico ($P_+$ y $P_-$) y el valor de salida del actuador de temperatura $T(k)$.
    \item Permitir al usuario modificar dinámicamente los parámetros del lazo de control, enviar \emph{setpoints}, seleccionar modos de operación (Manual / Automático) y enviar comandos de control a la placa de control.
    \item Notificación inmediata y clara ante desvíos de los parámetros de sintonización, pérdidas de señal pulsada, fallas de comunicación o sobrepasos de umbrales en los fotodetectores.
    \item Almacenamiento periódico de la telemetría del sistema y eventos en archivos de registro (\emph{log files}) para su posterior análisis y diagnóstico.
\end{itemize}

Si bien no es requisito utilizar una norma puntual, se considera como una buena práctica seguir estándares probados, por lo tanto el diseño toma como base los lineamientos de la norma ISA-101 introducidos en la Sección~\ref{sec:isa101} y el principio de alarmas de la ISA-18.2, introducido en la Sección~\ref{sec:alarmas}.

\section{Principios de la norma ISA-101}
\label{sec:isa101}

La norma ANSI/ISA-101.01-2015 (\emph{Human Machine Interfaces for Process Automation Systems}) establece directrices de diseño orientadas a maximizar la conciencia situacional (\emph{situation awareness}) del operador, reducir el tiempo de respuesta ante eventos anómalos y minimizar la fatiga visual. Para la implementación de la HMI del sistema HSRL se adoptaron los siguientes principios fundamentales de la norma \cite{isa101}:

\begin{enumerate}
    \item \textbf{Filosofía de color simplificada y funcional:} se emplean fondos neutros en tonos de gris claro para los paneles y ventanas principales, evitando contrastes elevados que generen cansancio visual durante jornadas prolongadas de medición. El uso de colores vivos se reserva exclusivamente para la representación de estados de alarma o advertencias (rojo para fallas críticas, amarillo/ámbar para advertencias y verde o gris neutro para estados normales de operación).
    \item \textbf{Jerarquía estructurada de pantallas:} se define una distribución organizada del contenido funcional dividida en áreas bien delimitadas:
    \begin{itemize}
        \item \emph{Barra de estado superior (Header):} muestra el estado global de conexión serie, modo de operación actual (Manual/Automático) y el indicador sintético de sintonización (\emph{LOCKED/UNLOCKED}).
        \item \emph{Panel de proceso y gráficos en tiempo real:} despliega tendencias temporales de las señales $P_+$, $P_-$ y parámetros del control por histéresis, permitiendo evaluar la estabilidad del lazo de control de un solo vistazo.
        \item \emph{Panel de comandos y ajustes:} agrupa los controles interactivos para ingresar \emph{setpoints}, modificar el punto de operación y modo.
    \end{itemize}
\end{enumerate}

\section{Alarmas del sistema}
\label{sec:alarmas}

La gestión de alarmas se diseñó siguiendo los principios de la norma ANSI/ISA-18.2 (\emph{Management of Alarm Systems for the Process Industries}). El objetivo es garantizar que cada alarma presentada al operador responda a una condición anómala real que requiera una acción o toma de decisión consciente, evitando el fenómeno de desensibilización por saturación de alarmas (\emph{alarm flooding}) \cite{isa182}.

Las alarmas de la HMI se categorizan en dos niveles de prioridad:

\begin{itemize}
    \item \textbf{Prioridad Alta:} condición que compromete el funcionamiento del sistema o la integridad de la medición (por ejemplo, pérdida total de pulsos en los fotodetectores, error de comunicación serie prolongado o desintonización crítica del lazo). Requiere atención inmediata del operador. Representación en rojo.
    \item \textbf{Prioridad Media:} desviaciones temporales de la temperatura por encima de los umbrales de tolerancia preestablecidos, o variaciones térmicas drásticas en el actuador $T(k)$. Representación en amarillo/ámbar.
\end{itemize}

\section{Modelo de HMI}

A partir de los criterios establecidos en la Sección \ref{sec:reqhmi} y las normas discutidas en las Secciones \ref{sec:isa101} y \ref{sec:alarmas} se creó el borrador de HMI presentado en la Figura \ref{fig:inks}, con los botones y comandos necesarios para la operación de sistema, utilizando el software Inkscape.

\begin{figure}
    \centering
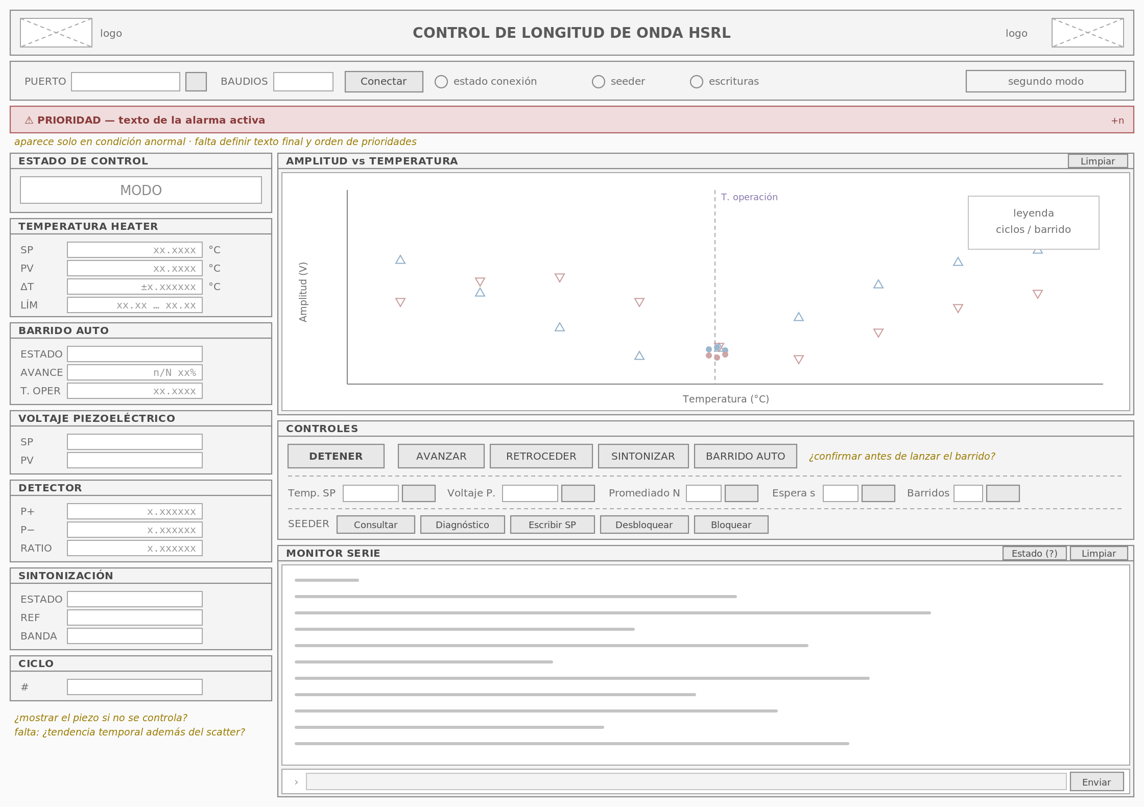
[picture p35: informe/figuras/8_borradorhmi.png]
    
    \caption{Borrador de la HMI creado en Inkscape (Fuente: elaboración propia).}
    \label{fig:inks}
\end{figure}

\section{Arquitectura del software en Python}
\label{sec:arquitectura_python}
\label{sec:hmi-arquitectura}

Se implementó la HMI en Python, con Tkinter para la interfaz gráfica. El código fuente se documenta y versiona en el repositorio del proyecto. La aplicación tiene exactamente dos dependencias externas fundamentales: \texttt{pyserial} para la comunicación por puerto USB con la placa de control y \texttt{matplotlib} para la representación gráfica; Tkinter forma parte de la biblioteca estándar. El software se organiza en siete módulos, según muestra la Figura~\ref{fig:hmi-modulos}.

\begin{figure}[htbp]
    \centering
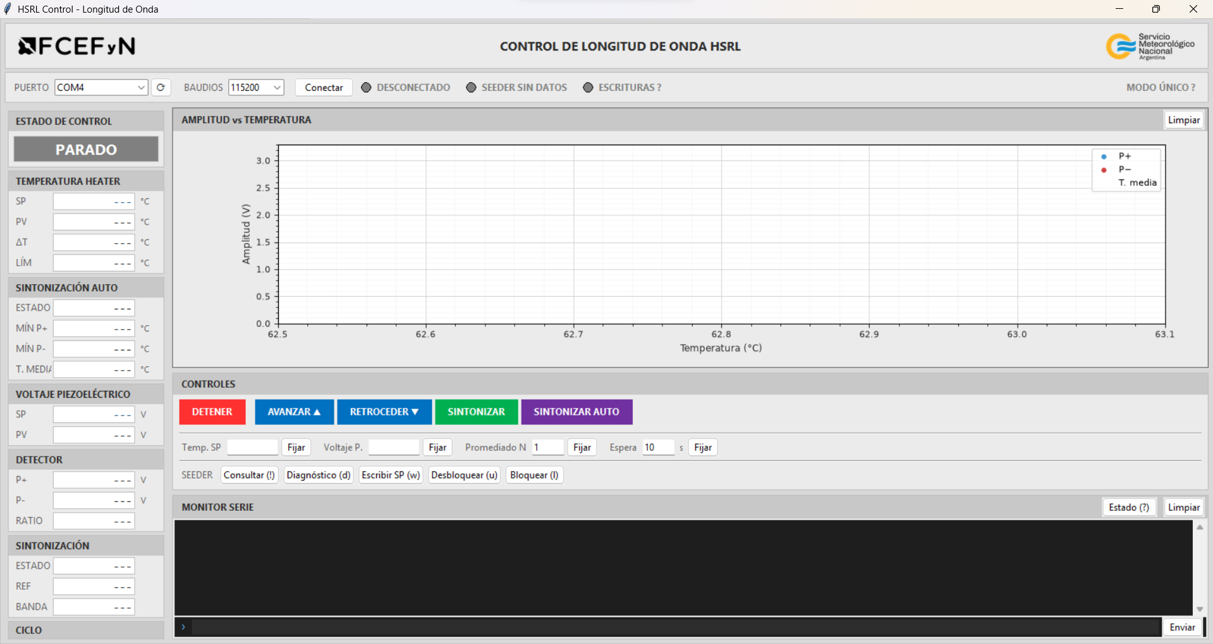
[picture p36: informe/figuras/8_hmilayout.png]
    
    \caption{HMI generada por \texttt{hmi.py}, a partir de la referencia proporcionada al modelo de inteligencia artificial Claude Opus 4.7 \cite{claudeopus47} (Fuente: elaboración propia).}
    \label{fig:hmiopus}
\end{figure}

La base de los módulos \texttt{hmi.py}, \texttt{serie.py} y \texttt{telemetria.py} fue creada a partir del uso del modelo de IA Claude Opus 4.7 \cite{claudeopus47}, con la consigna ``crear HMI a partir de la imagen de borrador proporcionado. Cada comando de la recepción mediante pySerial debe interactuar con el \emph{firmware} proporcionado con sus respectivos botones y campos de E/S y debes de loggear el estado del equipo a través de las líneas de diagnóstico del mismo''. Luego fueron modificados y adaptados según la necesidad del proyecto. Los archivos proporcionados de referencia para el modelo fueron el borrador de la Figura \ref{fig:inks} y los archivos \emph{hsrl-control.c} y \emph{config.h}, junto con el registro de la terminal durante 40 ciclos de adquisición.

\begin{figure}[htbp]
\centering
\resizebox{\textwidth}{!}{\input{diagramas/hmi-modulos}}
\caption{Arquitectura de módulos de la interfaz de operación (Fuente: elaboración propia).}
\label{fig:hmi-modulos}
\end{figure}

\begin{table}[htbp]
\centering
  \begin{tabular}{@{}p{0.24\textwidth}p{0.68\textwidth}@{}}
  \toprule
  \textbf{Módulo} & \textbf{Responsabilidad} \\
  \midrule
  \texttt{hmi.py} & Clase \texttt{HmiApplication}: construcción de la pantalla, ciclo de sondeo, envío de comandos y secuencia de sintonización automática. Punto de entrada. \\
  \texttt{serie.py} & Clase \texttt{SerialLink}: apertura, cierre, hilo de lectura y cola de líneas. Traduce toda falla del puerto a \texttt{SerialLinkError}. \\
  \texttt{telemetria.py} & Modelo del proceso (\texttt{ProcessData}) y análisis de las líneas de texto del \emph{firmware}. \\
  \texttt{registro.py} & \texttt{session\_log()} para el \textit{timestamp} y \texttt{CycleCsvWriter} para la escritura del archivo CSV. \\
  \texttt{widgets.py} & Componentes reutilizables (\texttt{StatusIndicator}, \texttt{StatusLabel}, \texttt{group\_box()}, \texttt{value\_row()}) con el estilo ya aplicado. \\
  \texttt{estilo.py} & Paleta y tipografía conforme a ISA-101. \\
  \texttt{firmware.py} & Constantes que deben coincidir con las del \emph{firmware}. \\
  \bottomrule
  \end{tabular}
  \caption{Responsabilidad de cada módulo de la interfaz (Fuente: elaboración propia).}
  \label{tab:hmi-modulos}
\end{table}

Para centralizar los datos del proceso se utiliza la clase \texttt{ProcessData}. Esta clase posee todos sus atributos declarados en el constructor, con la unidad y el significado al lado, lo que hace que el modelo del proceso se lea como una especificación de qué sabe la interfaz sobre el instrumento. La ventaja de esta aproximación es que permite probar separado el módulo \texttt{telemetria.py} del resto de la interfaz, para validar respuestas del microcontrolador sin necesidad de pasar por la interfaz HMI. Esta clase se discute más en detalle en la Sección~\ref{sec:hmi-telemetria}.

\section{Puerto serie y concurrencia}
\label{sec:hmi-concurrencia}

Tkinter impone que todo acceso a los componentes gráficos debe ocurrir desde el hilo que ejecuta el bucle de eventos (invocado por \texttt{hmi.py}). Al mismo tiempo, la lectura del puerto serie debe ser continua para no perder datos. La estructura adoptada, ilustrada en la Figura~\ref{fig:hmi-datos}, resuelve ambas restricciones.

\begin{figure}[htbp]
\centering
\resizebox{0.85\textwidth}{!}{\input{diagramas/hmi-datos}}
\caption[Diagrama de flujo de un ciclo de \textit{log}]%
{Recorrido de un ciclo de telemetría desde el puerto hasta la interfaz gráfica (Fuente: elaboración propia).}
\label{fig:hmi-datos}
\end{figure}

\begin{itemize}
\item Un \textbf{hilo secundario} creado en la clase SerialLink lee del puerto, acumula los bytes en un buffer, separa las líneas completas y las deposita en una \texttt{queue.Queue}.
\item El \textbf{hilo principal} ejecuta \texttt{\_poll\_serial()} cada $100$\,ms, con \texttt{root.after()}. Este hilo lee la cola de mensajes completos, la vacía y actualiza la interfaz gráfica.
\end{itemize}

Cuando no hay bytes disponibles, el hilo secundario duerme $5$\,ms y cuando directamente no hay puerto abierto, la pausa sube a $50$\,ms. Esta implementación es para evitar consumir recursos innecesariamente cuando no existan datos por leer. Las fallas de \texttt{pyserial} se traducen dentro de \texttt{serie.py} a una excepción propia, \texttt{SerialLinkError}.

\section{Lectura de datos del proceso}
\label{sec:hmi-telemetria}

Como se estableció en la Sección~\ref{sec:fw-log}, el \emph{firmware} envía al finalizar un ciclo de medición una línea \texttt{[log]}, y anuncia los nombres de sus columnas por separado en \texttt{[logcols]}. La interfaz se apoya íntegramente en estos dos mecanismos y por lo tanto el estado del proceso se reconstruye a partir de esa única línea.

Mediante los nombres anunciados en \texttt{[logcols]} con los valores de la línea \texttt{[log]}, el programa construye un diccionario de nombre a texto. Luego ese diccionario se lee para obtener los campos que la interfaz necesita:

\begin{lstlisting}[language=Python,basicstyle=\ttfamily\footnotesize,
  columns=fullflexible,breaklines=true,frame=single,rulecolor=\color{black!30}]
fields = {}
values = data.log_row_raw.split(",")
for i in range(len(data.log_columns)):
    if i < len(values):
        fields[data.log_columns[i]] = values[i].strip()

data.cycle_number    = _to_int(fields.get("ciclo", ""), data.cycle_number)
data.heater_setpoint = _to_float(fields.get("heater_sp", ""), data.heater_setpoint)
data.heater_measured = _to_float(fields.get("heater_real", ""), data.heater_measured)
...
data.lock_active     = _to_bool(fields.get("lock_activo", ""), data.lock_active)
\end{lstlisting}

La separación en dos etapas hace que el resto de la función no dependa del orden de las columnas, y de ahí se consigue que el \emph{firmware} pueda agregar columnas sin romper la interfaz.

Las respuestas a comandos puntuales tales como consulta al \emph{seeder}, diagnóstico, bloqueo y desbloqueo, verificación de escritura o ecos de \texttt{A} y \texttt{E} no forman parte del ciclo de medición y llegan como texto libre. La función \texttt{parse\_line()} las resuelve como condiciones excluyentes, cada una con su retorno inmediato:

\newpage
\begin{lstlisting}[language=Python,basicstyle=\ttfamily\footnotesize,
  columns=fullflexible,breaklines=true,frame=single,rulecolor=\color{black!30}]
def parse_line(line, data):
    rest = _text_after(line, "[logcols]")
    if rest is not None:
        columns = [name.strip() for name in rest.split(",")]
        if columns:
            data.log_columns = columns
        return True

    rest = _text_after(line, "[log]")
    if rest is not None:
        _update_from_log(data, rest)
        return True
    ...
    return False
\end{lstlisting}

\subsection{La clase \texttt{ProcessData}}

\texttt{ProcessData} concentra el estado completo del proceso. Además de poseer como atributos los campos que provienen directamente de la telemetría, incorpora dos métodos que merecen mención.

El primer método importante es el seguimiento de mínimos, en \texttt{track\_minima()}. Mientras el sistema barre en temperatura, la interfaz conserva el valor mínimo de cada canal y la temperatura a la que ocurrió. El cálculo de mínimo tiene en cuenta el valor de temperatura anterior al último, puesto que el set point actual siempre corresponde al próximo ciclo.

\begin{lstlisting}[language=Python,basicstyle=\ttfamily\footnotesize,
  columns=fullflexible,breaklines=true,frame=single,rulecolor=\color{black!30}]
measured_at = self.heater_setpoint - self.heater_step   # temperatura de esta medicion

if self.min_p_plus == 0.0 or self.p_plus < self.min_p_plus:
    self.min_p_plus = self.p_plus
    self.temp_at_min_p_plus = measured_at
\end{lstlisting}

Sólo se consideran los valores obtenidos en ciclos de barrido.

El segundo es \texttt{clear\_seeder\_state()}, que vuelve la interfaz a los valores de inicio y la misma se llama al cerrar el puerto serie. Sin puerto conectado, no existe certeza sobre la condición actual del \emph{seeder}, por lo que mostrar valores antiguos podría inducir a error al operador.

\subsection{Representación gráfica de valores medidos}

El gráfico central de puntos de dispersión presenta $P_+$ y $P_-$ en función de la temperatura, con un punto por ciclo y una ventana móvil de los últimos $500$ ciclos. La elección de la temperatura como abscisa responde a que la magnitud de interés durante la sintonización es precisamente la dependencia de las amplitudes con la temperatura, y en esa representación los mínimos de ambos canales resultan visibles de forma directa. Una línea vertical punteada marca el punto medio entre los mínimos registrados.

Ambos ejes tienen límites fijos. El eje de ordenadas cubre el rango completo del conversor del microcontrolador, de $0$ a $3{,}3$\,V y el de abscisas cubre el rango de seguridad del calentador, $[h_{\min}, h_{\max}]$.

El costo de esta decisión es que los puntos fuera del rango de seguridad no se dibujan. Esta condición se consideró aceptable puesto que el \emph{firmware} no permite que el punto de consigna permanezca fuera de ese rango: la protección descripta en la Sección~\ref{sec:fw-control} lo devuelve a un valor seguro, de modo que un dato fuera del eje corresponde a una condición transitoria que la banda de alarmas señala.

\section{Gestión de alarmas}
\label{sec:hmi-alarmas}

La interfaz gestiona cinco condiciones anormales, cuya evaluación y selección se ilustra en la Figura~\ref{fig:hmi-alarmas} y se detalla en la Tabla~\ref{tab:hmi-alarmas}.

\begin{figure}[htbp]
\centering
\resizebox{\textwidth}{!}{\input{diagramas/hmi-alarmas}}
\caption{Evaluación y selección de la alarma presentada en la banda (Fuente: elaboración propia).}
\label{fig:hmi-alarmas}
\end{figure}

\begin{table}[htbp]
\centering
  \begin{tabular}{@{}p{0.26\textwidth}cp{0.52\textwidth}@{}}
  \toprule
  \textbf{Alarma} & \textbf{Prioridad} & \textbf{Significado} \\
  \midrule
  Segundo modo detectado & Alta & El \emph{seeder} abandonó la operación en monomodo; la medición del ciclo no es confiable. \\
  Temperatura fuera de límites & Alta & La temperatura medida quedó fuera del rango que declara el \emph{firmware}. \\
  Temperatura cerca del límite & Media & La temperatura ingresó en el $5\%$ final del rango. \\
  Escrituras protegidas & Media & El \emph{seeder} ignora los \emph{setpoint}; requiere desbloqueo. \\
  Seeder sin respuesta & Media & No hay lectura real de temperatura ni de tensión del piezoeléctrico. \\
  \bottomrule
  \end{tabular}
  \caption{Alarmas gestionadas por la interfaz (Fuente: elaboración propia).}
  \label{tab:hmi-alarmas}
\end{table}

Las alarmas activas se ordenan por prioridad y se presenta únicamente la de mayor jerarquía. Presentarlas todas simultáneamente reproduciría el problema que la norma busca evitar: una pantalla saturada de avisos en la que el operador deja de distinguir el importante. La banda se oculta por completo cuando no hay condiciones activas, de modo que su sola aparición ya constituye información.

 La alarma de temperatura, implementada como \texttt{heater\_alarm\_priority(data)}, devuelve la prioridad o \texttt{None}. Esa misma función alimenta tanto el coloreado del indicador en el panel como la banda de alarmas.

Además de la banda, la barra superior presenta cuatro indicadores permanentes (enlace USB, enlace con el \emph{seeder}, estado de las escrituras y modo único) cada uno con tres estados posibles, incluido el estado «sin dato». La distinción entre «sin dato» y «normal» evita que la pantalla afirme normalidad cuando en realidad no ha recibido información.

\section{Sintonización automática}
\label{sec:hmi-auto}

\subsection{Fundamento}

La búsqueda del punto de operación descripta en la Sección~\ref{sec:fw-principio} es un procedimiento de varios pasos que el operador puede ejecutar a mano. Automatizarlo reduce el tiempo de puesta en marcha y elimina una fuente de error, pero plantea la cuestión de dónde realizar la implementación.

La decisión fue implementarlo en la interfaz y no en el \emph{firmware}, por dos razones. La primera es que la secuencia es una \emph{política} y no un \emph{mecanismo}: depende de criterios que pueden ajustarse con la experiencia de operación, y modificarla no debería requerir recompilar y reprogramar el microcontrolador. La segunda es que la secuencia se construye enteramente con comandos que el \emph{firmware} ya expone, de modo que su implementación en la interfaz no agrega superficie de falla al componente crítico.

\subsection{Desarrollo de la secuencia}

El diagrama de flujo de la Figura~\ref{fig:hmi-auto} detalla la secuencia completa. Mientras el sistema barre, la interfaz sigue los mínimos de cada canal y muestra en vivo la temperatura media resultante. Al activarse la sintonización automática:

\begin{enumerate}
\item Se envía \texttt{s} para que el calefactor deje de barrer. Sin este paso, el ciclo siguiente sumaría el paso grueso y el sistema se desplazaría del punto buscado.
\item Se envían \texttt{T} con la temperatura media y \texttt{w}. El segundo comando fuerza la escritura inmediata al \emph{seeder}, sin esperar a que el microcontrolador concluya el ciclo en curso, que podría estar en medio de una pausa de estabilización de varios segundos.
\item Se aguardan $20$\,s de estabilización térmica (\texttt{AUTO\_SETTLE\_TIME\_S}).
\item Se dejan transcurrir cuatro ciclos con el calefactor en una temperatura determinada.
\item Se envía \texttt{g}. Como la sintonización toma su referencia del cociente de dos ciclos atrás, a esa altura la referencia corresponde a una medición ya estabilizada.
\end{enumerate}

\begin{figure}[htbp]
\centering
\resizebox{\textwidth}{!}{\input{diagramas/hmi-auto}}
\caption[Diagrama de flujo de la sintonización automática]%
{Diagrama de flujo de la secuencia de sintonización automática. Todos los comandos enviados son comandos que el operador puede emitir manualmente (Fuente: elaboración propia).}
\label{fig:hmi-auto}
\end{figure}

Los pasos 3 y 4 encadenan dos mecanismos distintos de temporización: el primero es un temporizador de la interfaz gráfica, y el segundo un contador de ciclos cerrados que se decrementa con cada línea \texttt{[log]}. Esto es a propósito, puesto que la espera de estabilización es un intervalo de tiempo físico, mientras que la cantidad de ciclos a descartar depende del ritmo del \emph{firmware}, que a su vez depende de parámetros que el operador puede haber modificado.

\section{Generación de registros de la HMI}
\label{sec:hmi-registro}

Cada ejecución genera dos archivos en el directorio \texttt{logs/}, ambos nombrados con la misma marca temporal de inicio para poder referenciarlos:

\begin{itemize}
\item \texttt{hsrl-AAAA-MM-DD\_hh-mm-ss.log}: \textit{logging} completa de la sesión, incluidos los comandos enviados, las líneas recibidas y los mensajes de la propia interfaz. Su destino es realizar análisis de incidentes.
\item \texttt{hsrl-AAAA-MM-DD\_hh-mm-ss.csv}: \textit{logging de proceso} una fila por ciclo de control. Su destino es realizar análisis de los datos.
\end{itemize}

El archivo CSV se construye anteponiendo la marca temporal y escribiendo a continuación el contenido de la línea \texttt{[log]} tal como llegó sin reformatear. El encabezado se toma de los nombres que el \emph{firmware} anunció en \texttt{[logcols]}. El archivo CSV se crea recién con la primera fila, de manera que abrir la interfaz sin conectar no deja archivos vacíos acumulándose en el directorio. Además cada fila se vuelca a disco inmediatamente después de ser registrada, por lo tanto si el programa se interrumpe no se pierden los ciclos ya registrados.
