FGalvagno/hsrl-control-pi/informe/preliminares/agradecimientos.tex

% =============================================================
% Agradecimientos
% Breve y directo - inicia en hoja nueva, todo en una hoja
% =============================================================
\chapter*{Agradecimientos}
\phantomsection
\addcontentsline{toc}{chapter}{Agradecimientos}
A mi director y mis codirectores, por su guía y apoyo durante el desarrollo del proyecto.

Al Servicio Meteorológico Nacional y al Observatorio Geofísico y Meteorológico de Pilar, por facilitar el acceso a los equipos y a las instalaciones para el desarrollo del proyecto.

A la Universidad Nacional de Córdoba, por la formación académica y profesional que me permitió llevar a cabo este trabajo.

\cleardoublepage
