FGalvagno/hsrl-control-pi/informe/anexos/anexo1_codigo_nies.tex

% =============================================================
% Anexo I - Hojas de datos de componentes
% =============================================================
\chapter{Código fuente original del sistema HSR}
\label{anexo:hsrlnies}

El código realizado originalmente para el control HSRL, concentrado en el archivo \textbf{wvcnt\_lec.cpp} se encuentra en el repositorio de GitHub \cite{repo}.
