FGalvagno/hsrl-control-pi/informe/anexos/anexo4_hojas_datos.tex

% =============================================================
% Anexo I - Hojas de datos de componentes
% =============================================================
\chapter{Hojas de datos de componentes}
\label{anexo:hojas_datos}

Las hojas de datos de los componentes utilizados en el desarrollo de la placa para control del HSRL se encuentran en el repositorio de GitHub \url{https://github.com/FGalvagno/hsrl-control-pi}. \cite{repo}
