FGalvagno/hsrl-control-pi/informe/anexos/anexo5_codigo.tex

% =============================================================
% Anexo III - Codigo fuente relevante
% Lineas de codigo que no se incluyen en el cuerpo del informe.
% Si el codigo es extenso, referenciar el repositorio del proyecto.
% =============================================================
\chapter{C\'odigo fuente relevante}
\label{anexo:codigo}

El código fuente relevante para el control del HSRL se encuentra en el repositorio de GitHub \url{https://github.com/FGalvagno/hsrl-control-pi}. \cite{repo}
