FGalvagno/hsrl-control-pi/informe/figuras/2_canales_hsrl.png

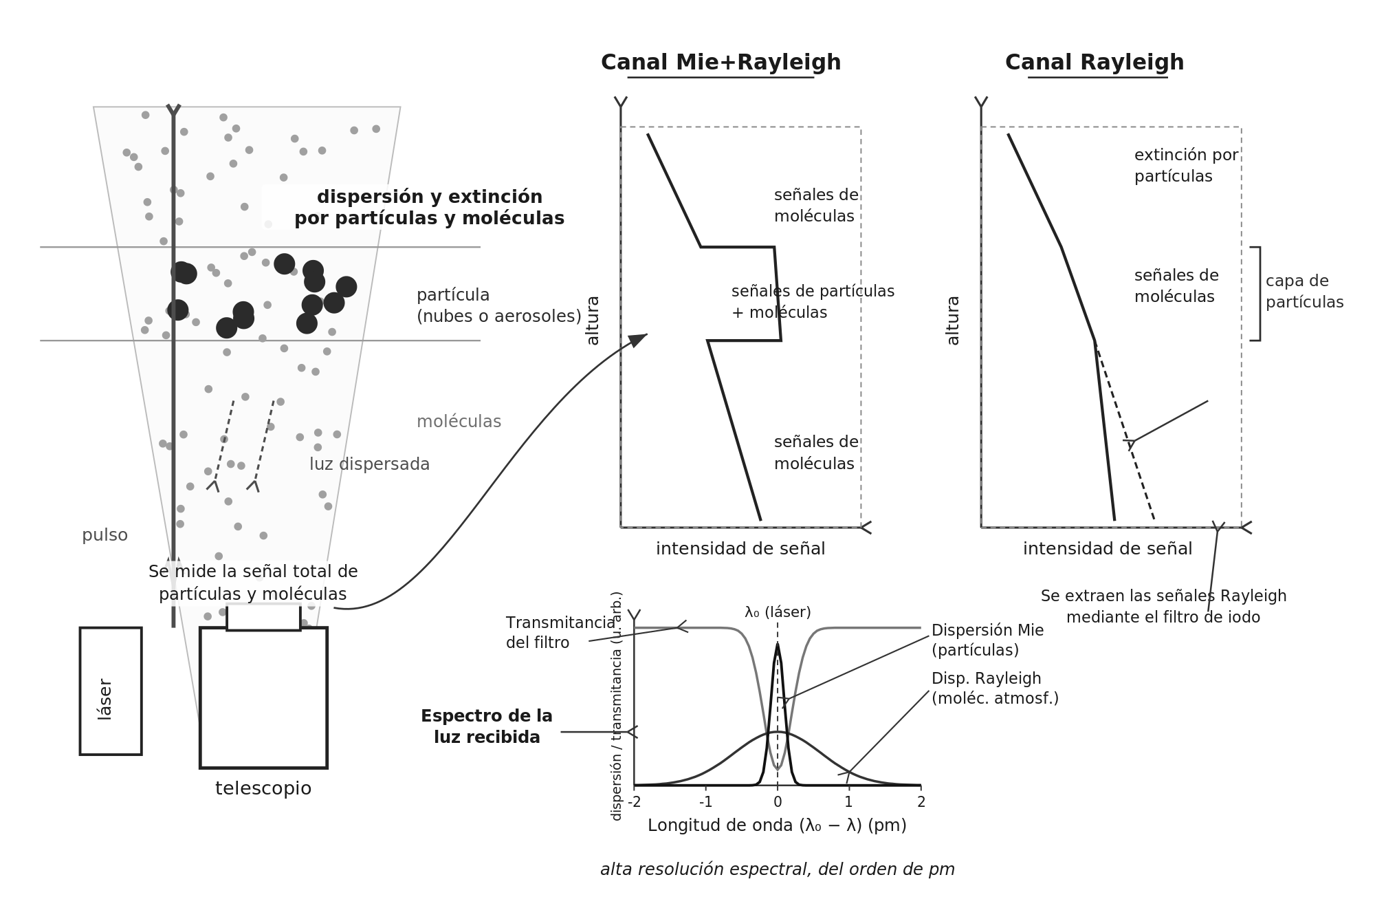
informe/figuras/2_canales_hsrl.png
