FGalvagno/hsrl-control-pi/informe/figuras/5_circuitoesquematico.png

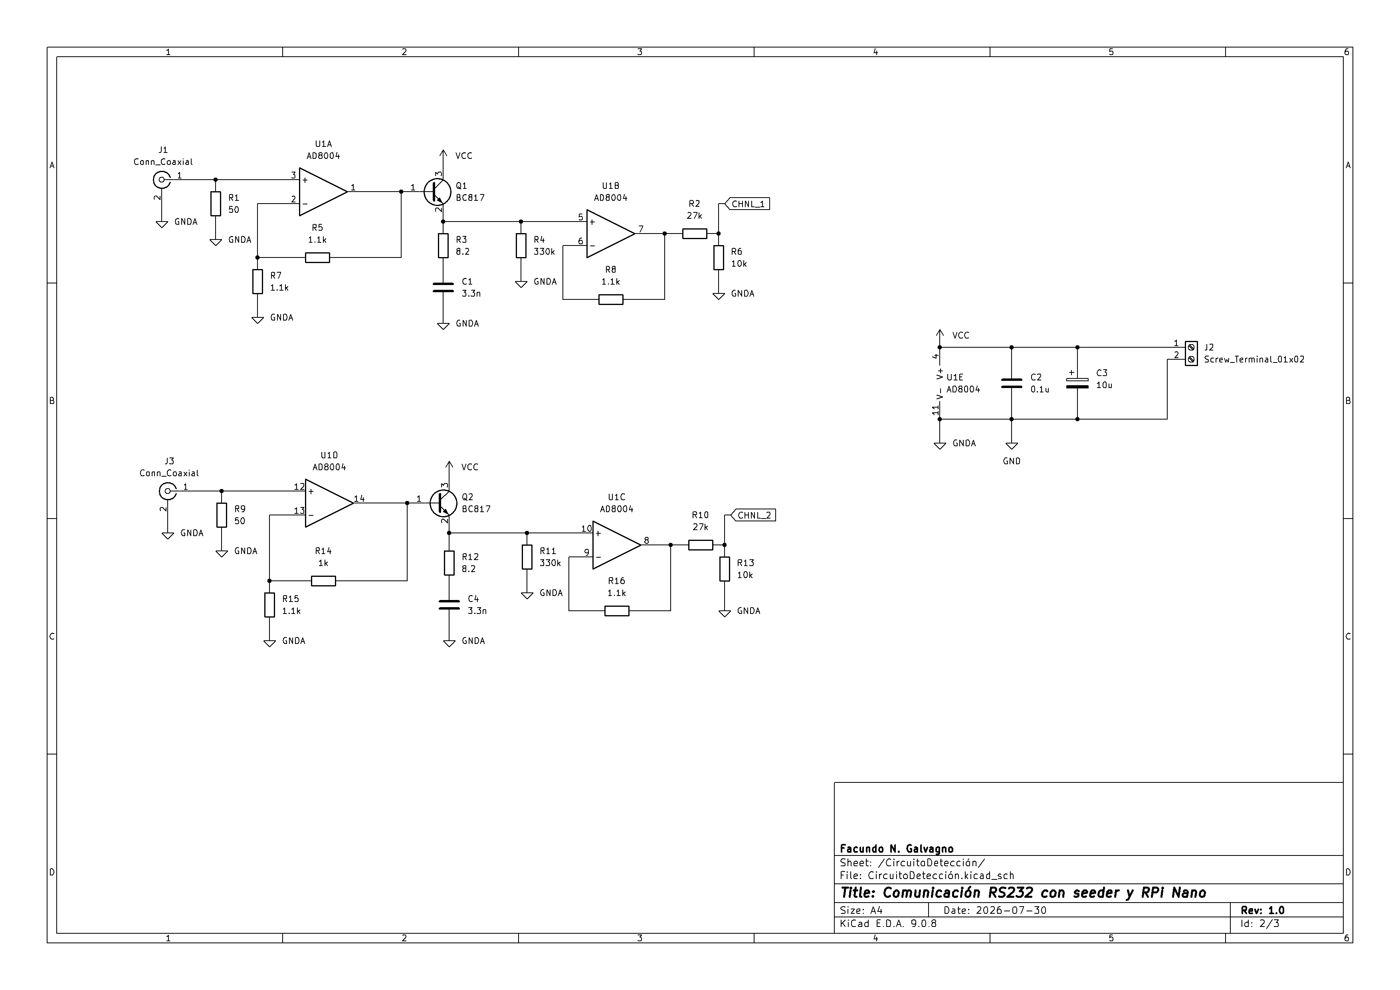
informe/figuras/5_circuitoesquematico.png
