FGalvagno/hsrl-control-pi/informe/figuras/9_lockhmi.png

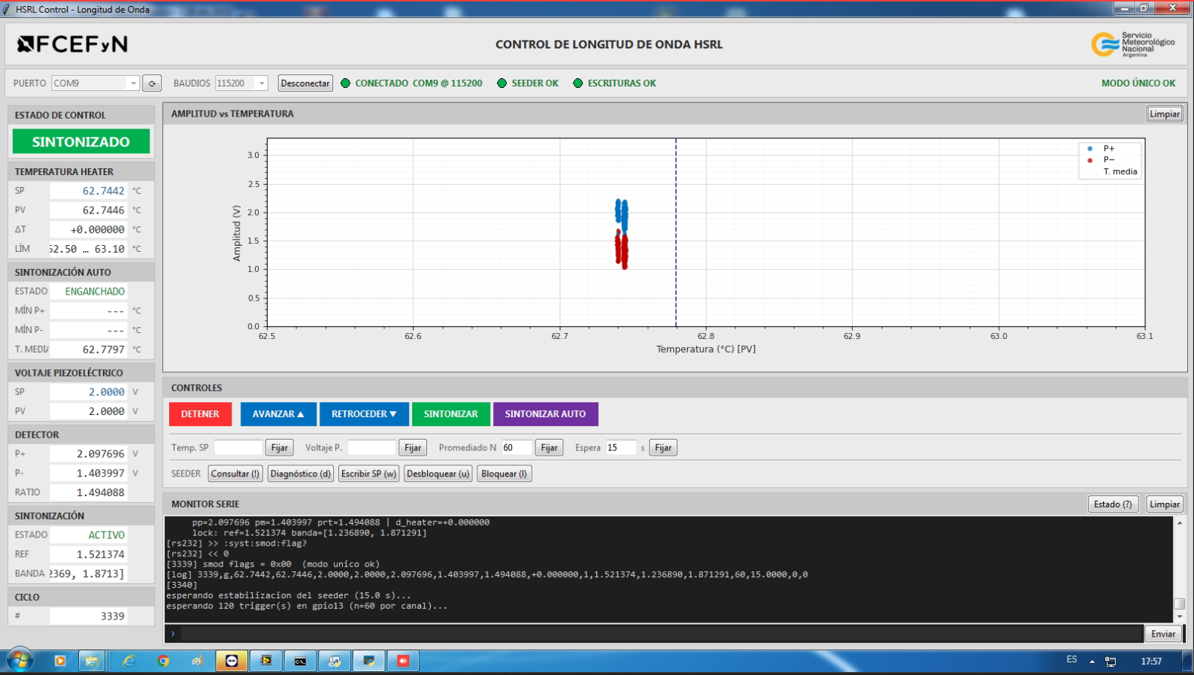
informe/figuras/9_lockhmi.png
