FGalvagno/hsrl-control-pi/informe/figuras/9_señalhsrl.png

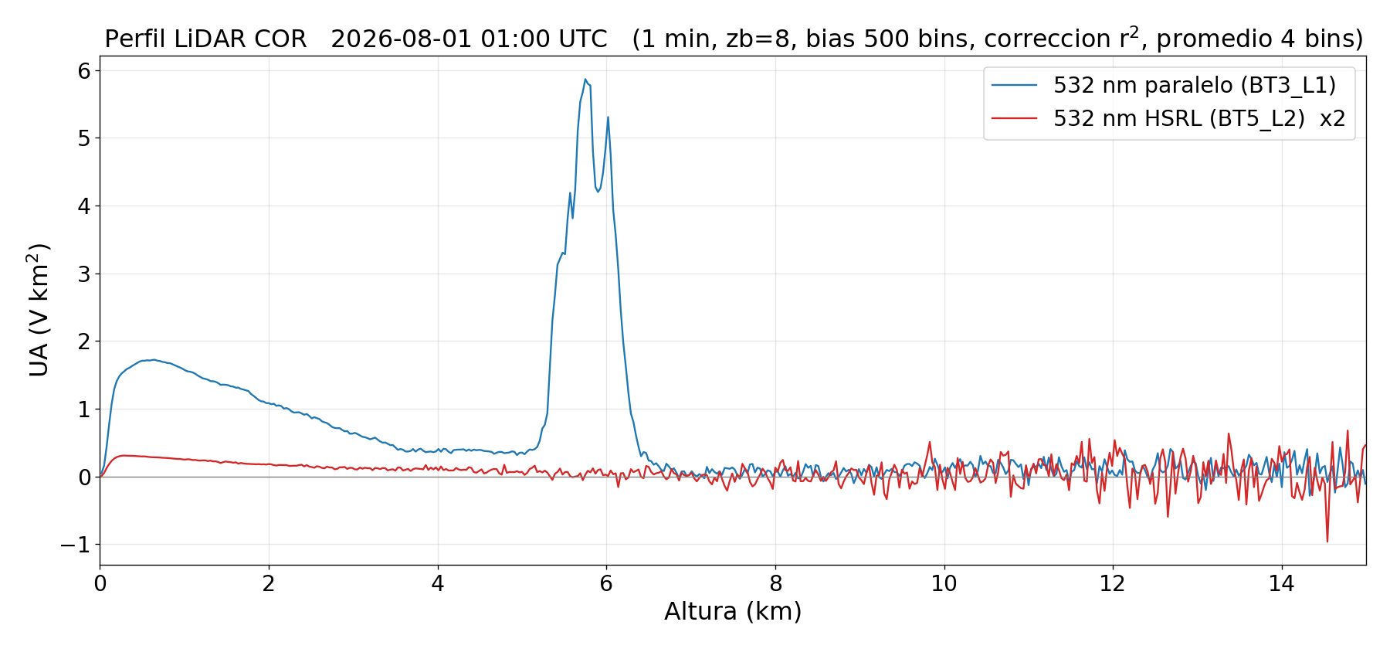
informe/figuras/9_señalhsrl.png
