FGalvagno/hsrl-control-pi/informe/figuras/9_sintonizando.png

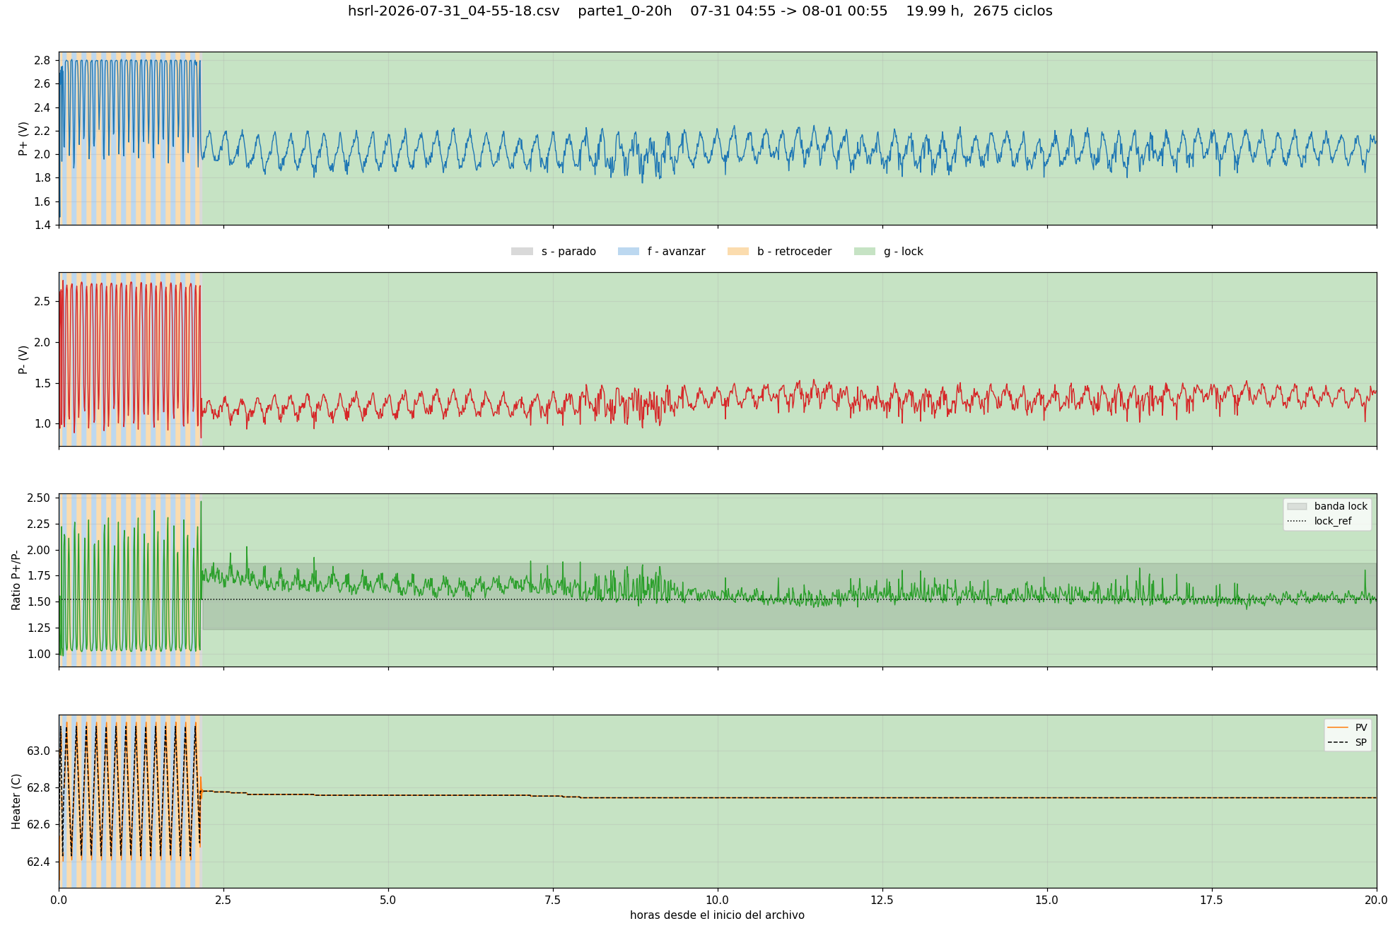
informe/figuras/9_sintonizando.png
