FGalvagno/hsrl-control-pi/(commit log)

2026-07-27 deteccion de picos
2026-07-27 placa de control
2026-08-02 añadidas hojas de datos y submodulos
2026-08-02 añadidas referencias de uso IA y sitios web
2026-08-02 Actualizada la escala del anexo
2026-08-02 Agregado titulo en anexo de informes mensuales
2026-08-02 Descripcion de ultimo anexo
2026-08-02 capitulos de software
2026-08-02 archivos de simulacion
    [PI5.sch]
2026-08-02 lista de simbolos vieja
2026-08-04 minimas correcciones de dicción
2026-08-04 actualizadas hojas de datos de micro de comparación
